sjtrny/yowie/README.md

# yowie

The YowieFC project aims to develop the neccesary hardware and software components for a flight controller with built in OSD that is entirely configurable from the cleanflight configurator.

Features of the YowieFC:

* 36mm form factor
* STM32F4 MCU
* On board OSD via MAX7456
* MPU-6000 (via SPI)
* Power from flight battery (up to 6S)
* 12V 1A supply for FPV camera and transmitter
* 4 ESC/PWM out
* On board S.BUS inverter
* Voltage Sensing
* RSSI In
* Buzzer Out
