sjtrny/yowie/state_pics/2015_11_24.jpg

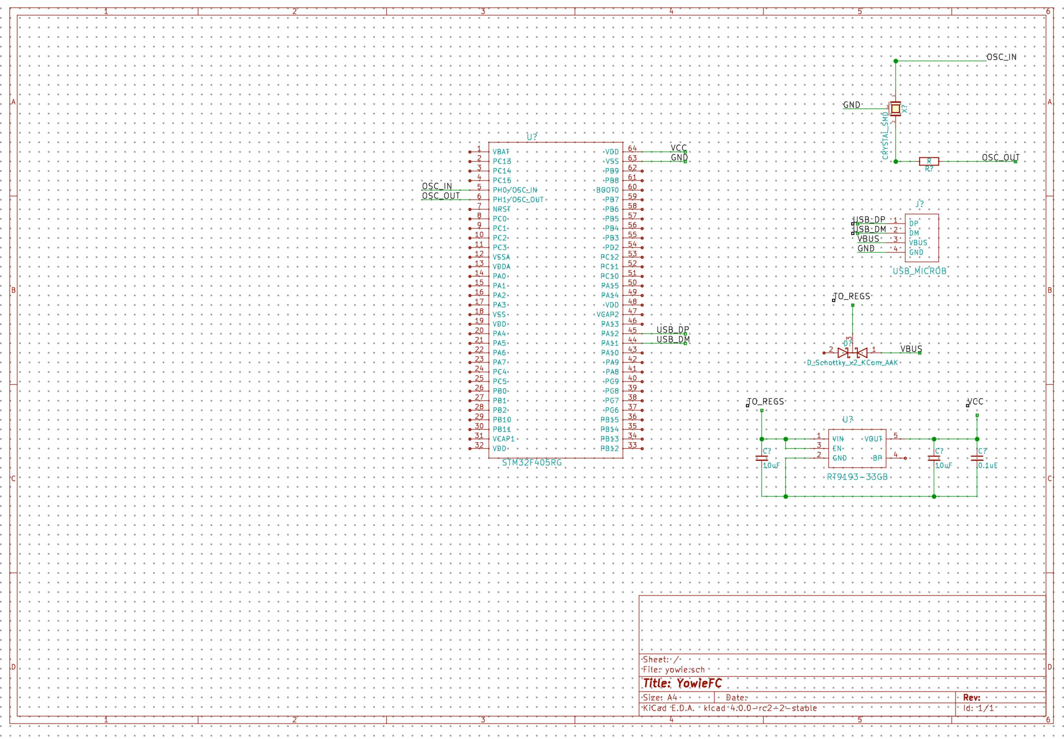
state_pics/2015_11_24.jpg
