sjtrny/yowie/state_pics/2015_12_1.png

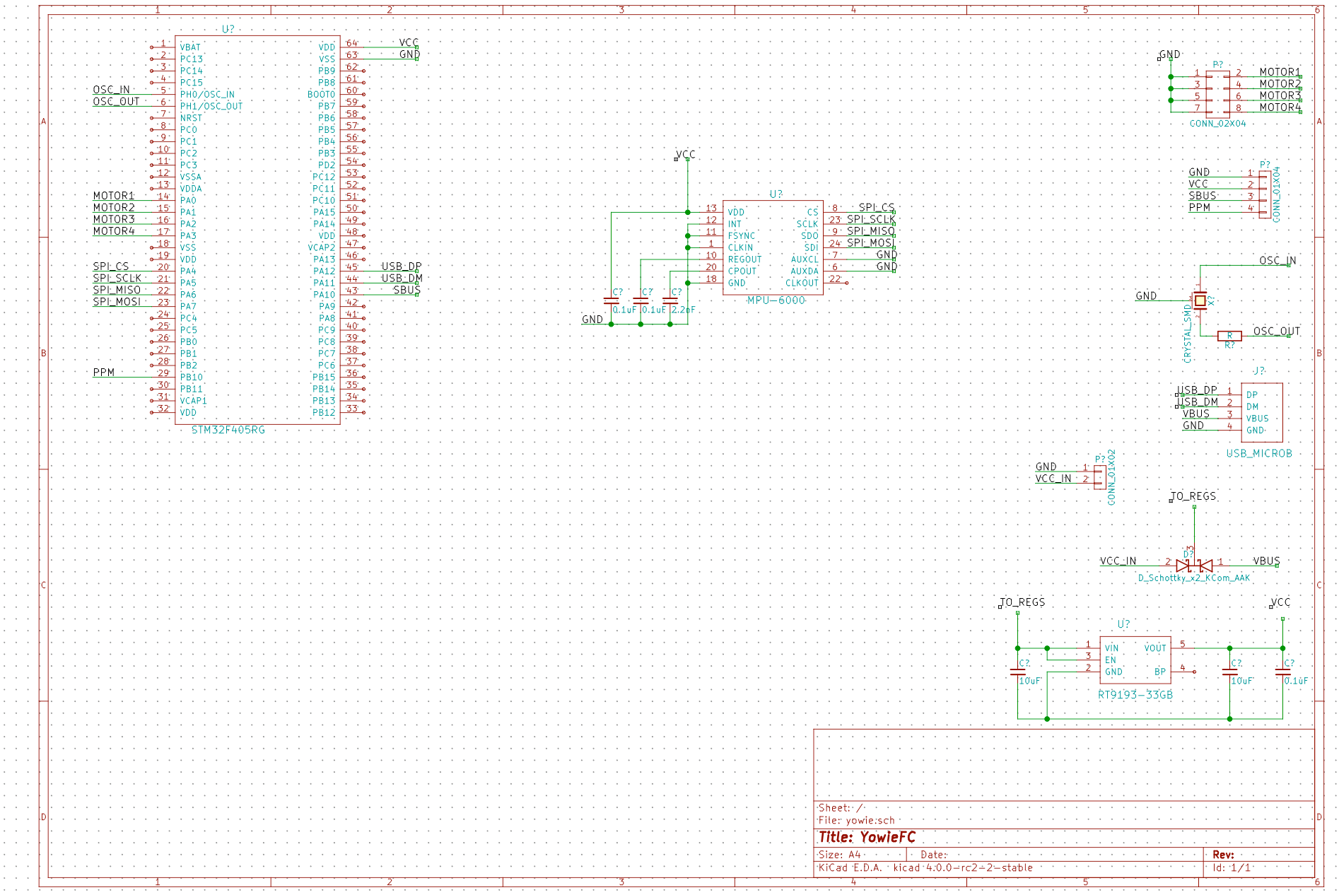
state_pics/2015_12_1.png
