sjtrny/yowie/state_pics/2015_12_2.png

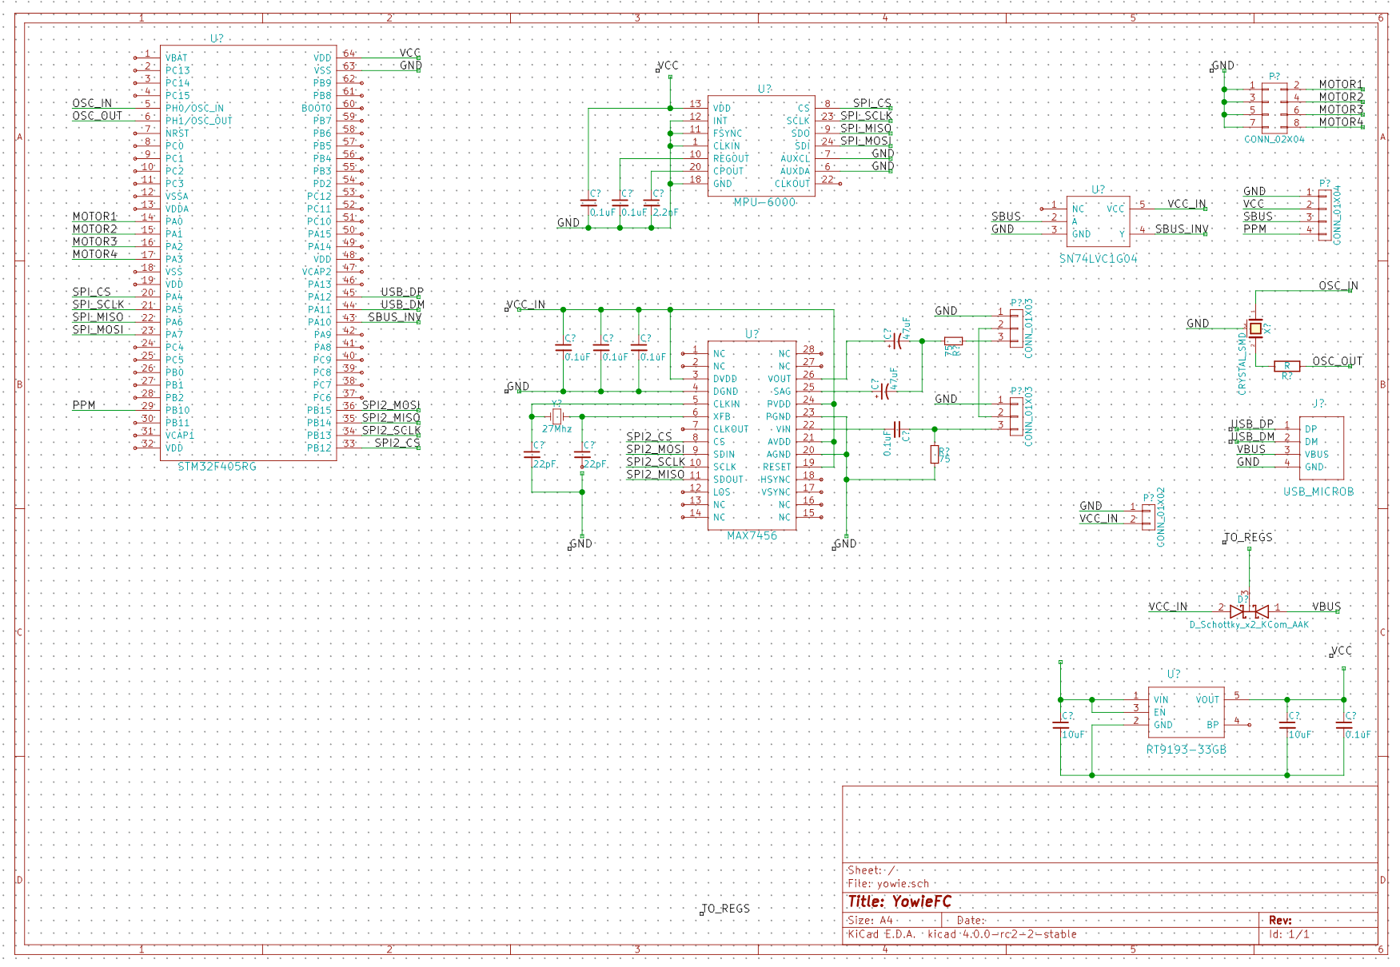
state_pics/2015_12_2.png
