sjtrny/yowie/state_pics/2015_12_3.png

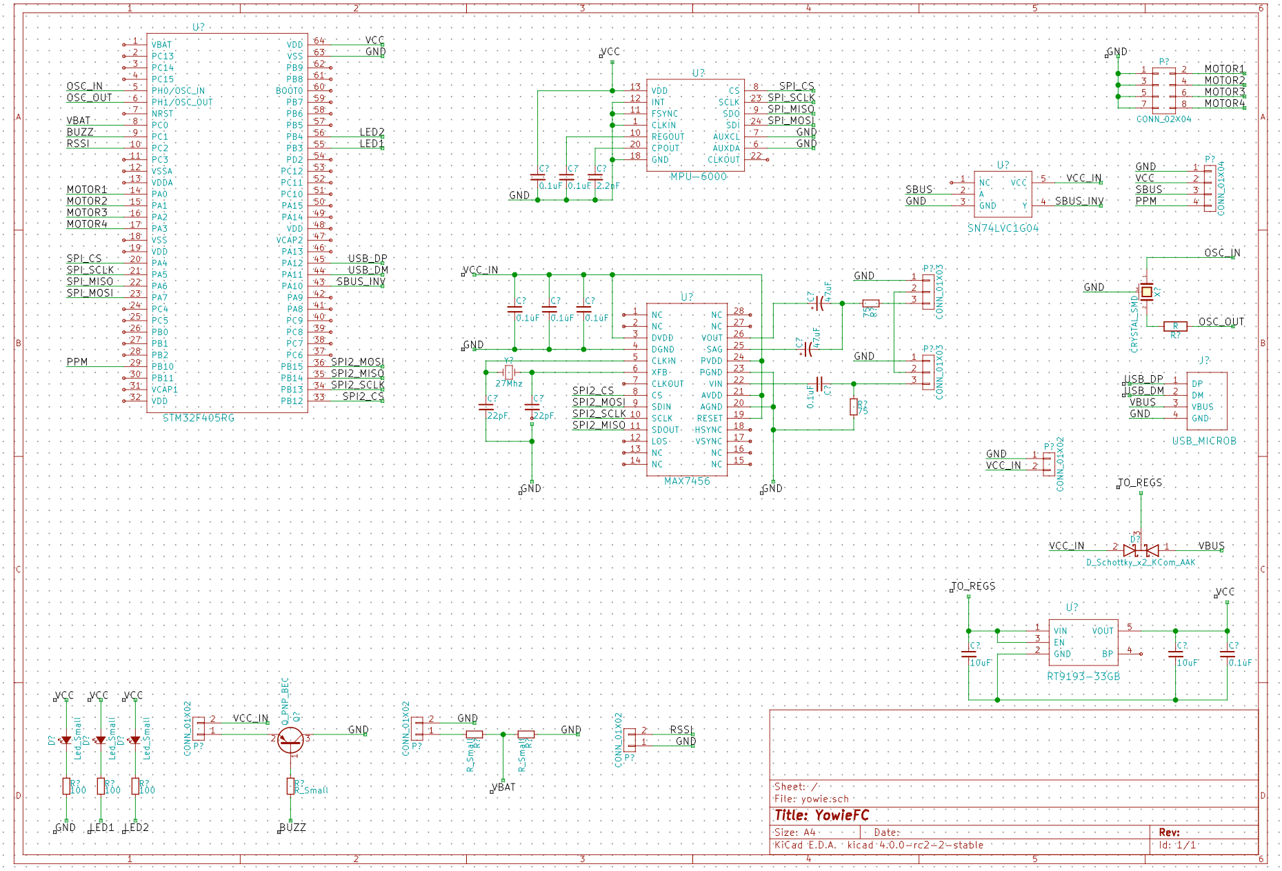
state_pics/2015_12_3.png
