sjtrny/yowie/example_schematics/SparkFun_On_Screen_Display-MAX7456.pdf

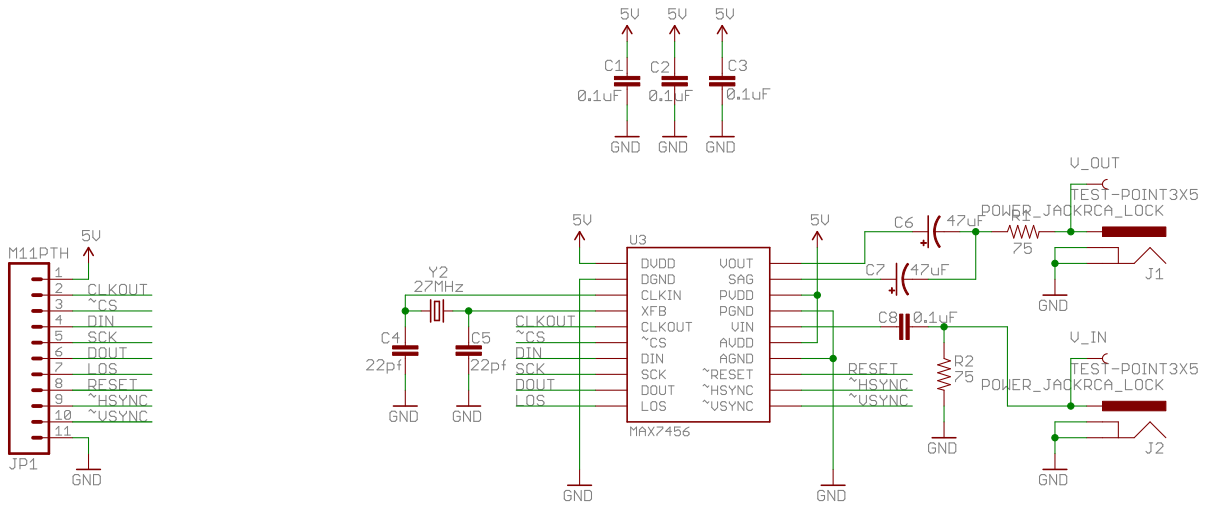
[picture p5: page 1]
