sjtrny/yowie/(threads)

Thread 1 (2015-12-03):

6S+ Tolerance

sjtrny, 2015-12-03:
- Upgrade vreg to 6S tolerance
- Seems like a simple swap but has hidden complications
- Need to actually add two regs (3.3V and 5V) since some components need 5V
- Diodes need to be checked that they support high voltages

List of affected 5V units:
- MAX7456
- Buzzer
- RX power
- SBUS Inverter

sjtrny, 2015-12-08:
After further research it seems that the best choice for regulator is a step-down switching buck regulator rather than an LDO regulator.

sjtrny, 2015-12-10:
Here are the best buck reg options I could find

300mA (3.3V and 5V)
- MAX15462 (42V)
- MAX15062 (60V)

500mA (3.3V and 5V)
- MAX17501 (60V)

At this stage the current consumption is really unknown but 300mA should be enough for both 3.3V and 5V rails. The 500mA option is there in case we need extra current capability. However moving to the 500mA option requires many additional supporting passives so we want to avoid it as much as possible.

Also note that both 300mA options have the same package, pinout and supporting passives so we can use them interchangeably in the schematic without issue.

sjtrny, 2015-12-10:
Completed 9cab61715bcabd8eb649f24a2e487e3e81639ebe

Closed 2015-12-10.

Thread 2 (2015-12-03):

Unify VBAT and VCC_IN

sjtrny, 2015-12-03:
- Depends on #1
- Minimise the number of pads/through holes
- Since we have upgraded board to 6S tolerance we can now safely branch off the main voltage input with the voltage divider circuit

Closed 2015-12-10.

Thread 6 (2015-12-03):

onboard frsky s.port converter

lolorc, 2015-12-03:
examples of such an converter :
https://github.com/TauLabs/TauLabs/wiki/User-Guide:-FrSKY-S.PORT-telemetry
https://github.com/xdandys/draco/raw/master/hw/draco.pdf
http://forum.taulabs.org/viewtopic.php?f=17&t=223&start=40#p3629

sjtrny, 2015-12-03:
Just to clarify some things I'm jotting down some notes about this:

- S.Port is a serial protocol and is inverted on FrSky hardware
- STM32F3 boards have inbuilt inverters for UART
- STM32F4 boards do not
- We need an inverter for this capability

sjtrny, 2015-12-03:
How popular is S.Port compared to normal FrSky telemetry? I haven't come across anyone in person using it yet.

lolorc, 2015-12-04:
it comes popular when you start using sbus receivers mainly. The X series receivers come with the smartport telemetry. it's a half duplex, inverted, uses a single line and doesn't require a hub to connect several devices together.
I personally use it with x4r-sb, a quanton FC and I use a flvss (lipo voltage sensor) to get individual cell voltages. The FC sends a lot of data, I basically use arming state, flight mode, gps status, voltages and amps

Thread 7 (2015-12-04):

Unify VCC out for RX

sjtrny, 2015-12-04:
Depends on #1

Once we have both 3.3V and 5V on the board we can then unify the pad/through hole for the RX VCC out. This could be accomplished with a jumper or bridging solder pads.

But that solution sucks and we can do better. Let use an Analog SPDT IC instead, which can be controlled by the MCU and configured in cleanflight.

Closed 2015-12-10.

Thread 8 (2015-12-07):

Add 12V reg for FPV gear

sjtrny, 2015-12-07:
To help with super clean builds and avoid the need for a more expensive PDB.

Bare minimum 1A without cooling.

sjtrny, 2015-12-10:
Here are the options

1A (12V)
- MAX5035 (72V)
- MAX17502G (60V)
- LM2575HV (60V, low external part count)

The LM2575HV seems to be the most suitable since it requires the least supporting passives and space is at a premium.

Closed 2015-12-10.

Thread 10 (2015-12-10):

Move PPM input pin to PB11/30

sjtrny, 2015-12-10:
Seems unnecessary to have a dedicated pin for PPM and SerialRX when they won't be used at the same time.

Closed 2015-12-10.

Thread 11 (2015-12-11):

Boot loader short

sjtrny, 2015-12-11:
Need to have pads for boot loader shorting or even a small button.
