sjtrny/yowie/(commit log)

2015-11-22 Created KiCad project
    [yowie.kicad_pcb, yowie.sch]
2015-11-23 Created STM32F405RG Part
    Added to main schematics
    [yowie.sch]
2015-11-24 Added USB and supporting infrastructure
    [yowie.sch]
2015-12-01 Added VCC_IN, RC in, ESC out
    [yowie.sch]
2015-12-01 Added SBUS Inverter
    [yowie.sch]
2015-12-02 Added MAX7456
    [yowie.sch]
2015-12-03 Added status LEDs, BUZZ out, VBAT in and RSSI in
    [yowie.sch]
2015-12-10 Added 3.3V and 5V regs and relabelled components to their required voltages
    [yowie.sch]
2015-12-10 Unified VBAT and VCC_IN
    Resolves #2
    [yowie.sch]
2015-12-10 Split ESC output connectors
    Resolves #4
    [yowie.sch]
2015-12-10 Merged PPM and SAT pins
    Resolves #5
    Resolves #9
    [yowie.sch]
2015-12-10 Added LM2575
    Also edited inductor values for 3.3V and 5V regs
    [yowie.sch]
2015-12-10 Completed wiring of 12V reg
    Resolves #8
    Also added in pads for access to all three greg outputs
    [yowie.sch]
2015-12-10 Tidied schematic layout
    [yowie.sch]
2015-12-10 Added Switch to control RX voltage out
    Resolves #7
    Resolves #10
    [yowie.sch]
